Vidoux/Meteo_Station_ENSTA/assets/trace_serial_LoRa_capteur.png

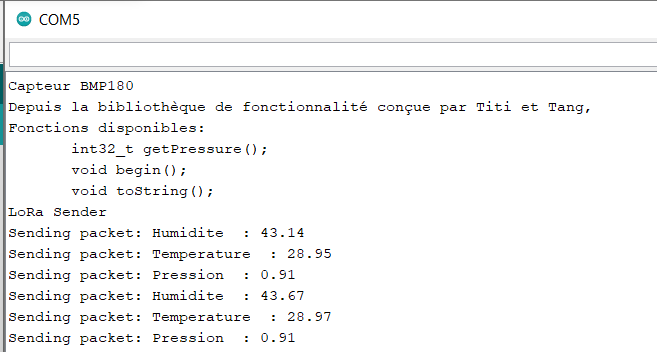
assets/trace_serial_LoRa_capteur.png
