Vidoux/Meteo_Station_ENSTA/assets/trace_serial_LoRa_serveur.png

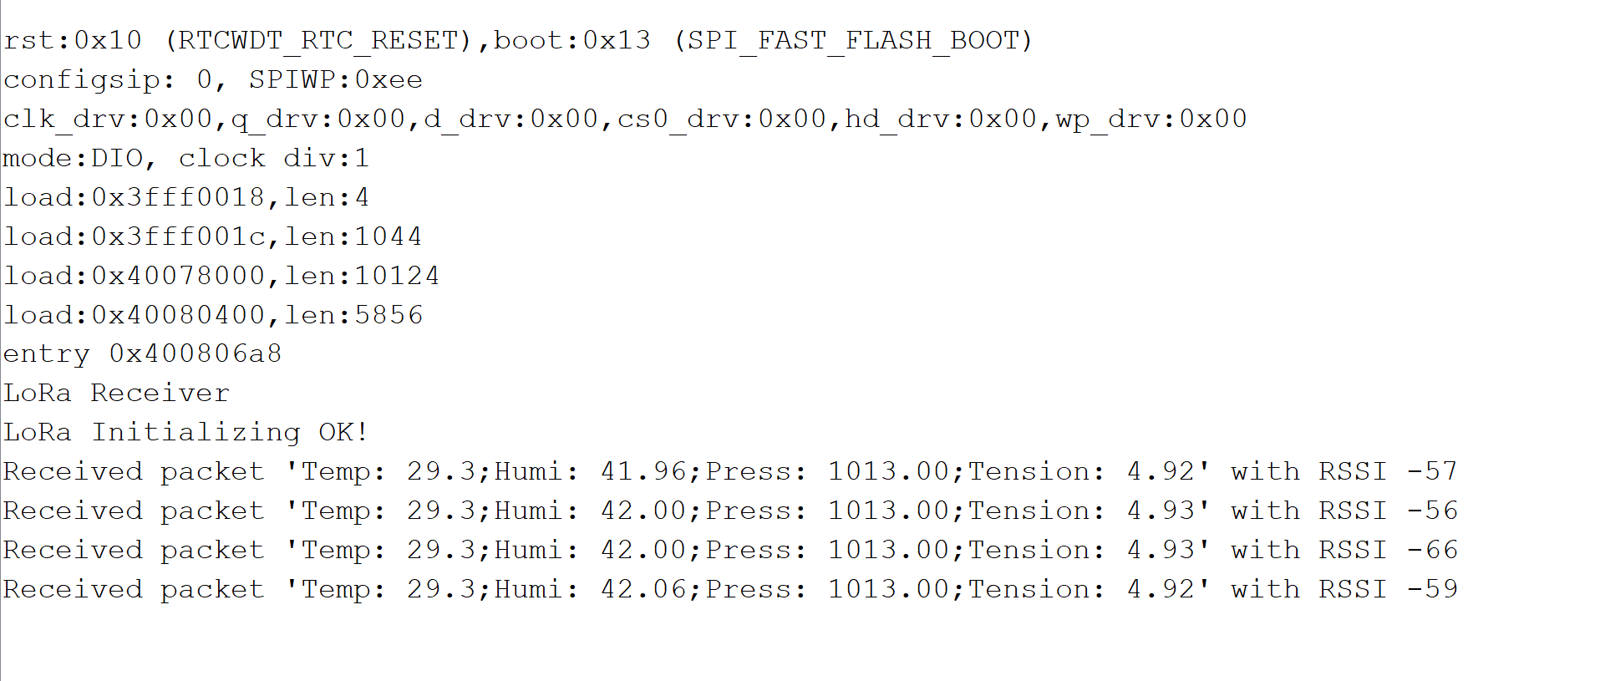
assets/trace_serial_LoRa_serveur.png
