Vidoux/Meteo_Station_ENSTA/assets/trace_serial_LoRa_serveur_bonne_reception.png

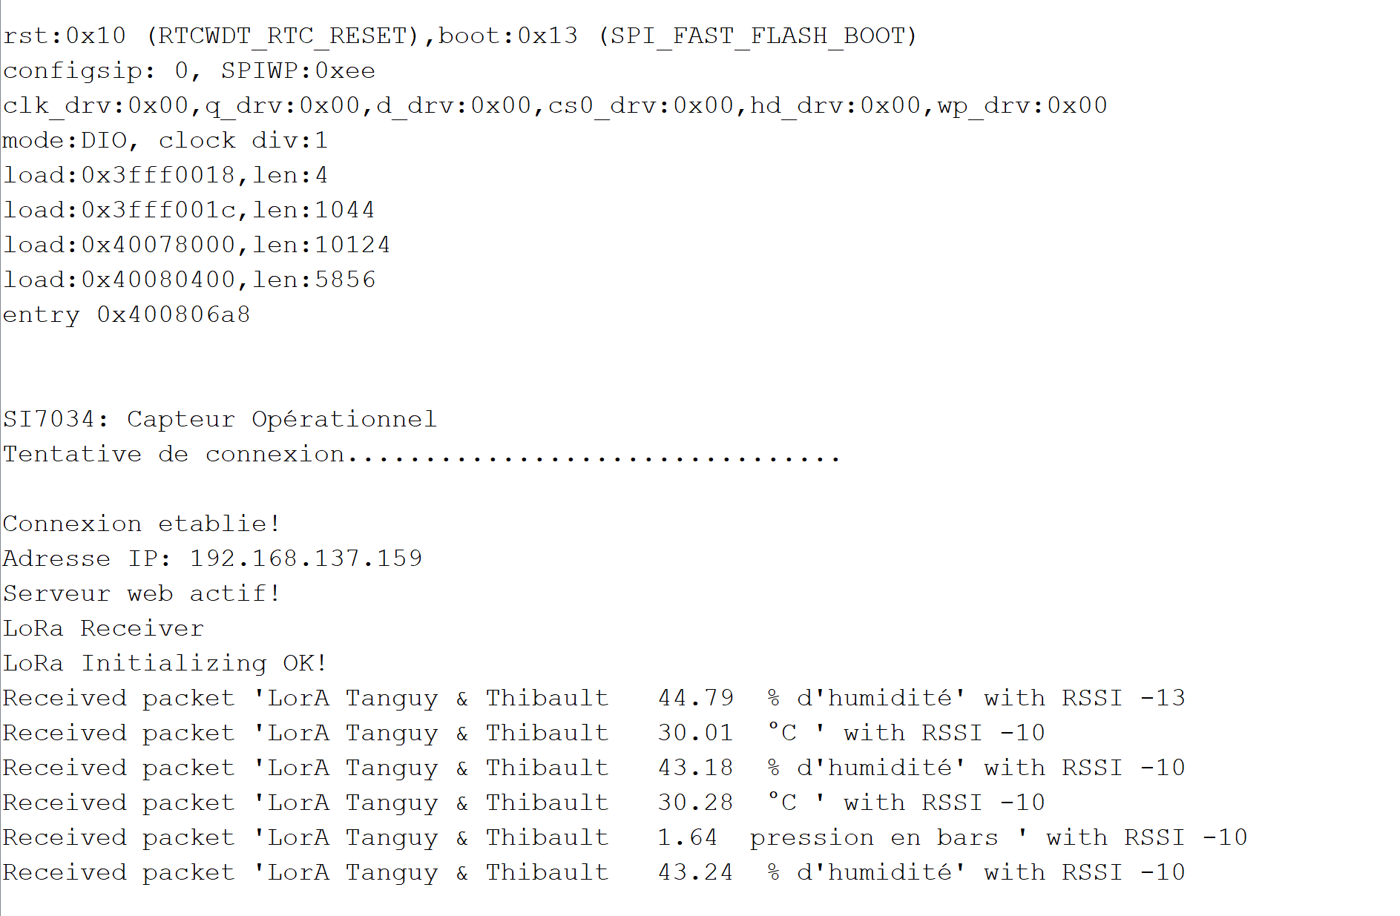
assets/trace_serial_LoRa_serveur_bonne_reception.png
